glocklueng/open-bioreactor/CAD_hardwareDesign/Assembly Prototype.jpg

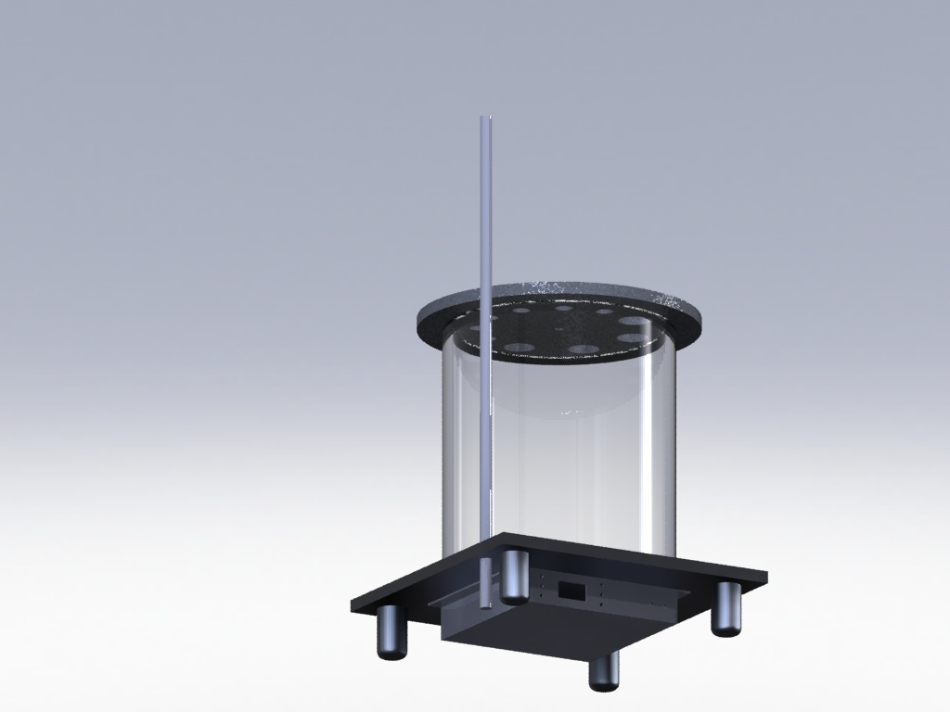
CAD_hardwareDesign/Assembly Prototype.jpg
