glocklueng/open-bioreactor/CAD_hardwareDesign/Assembly Prototype.SLDASM

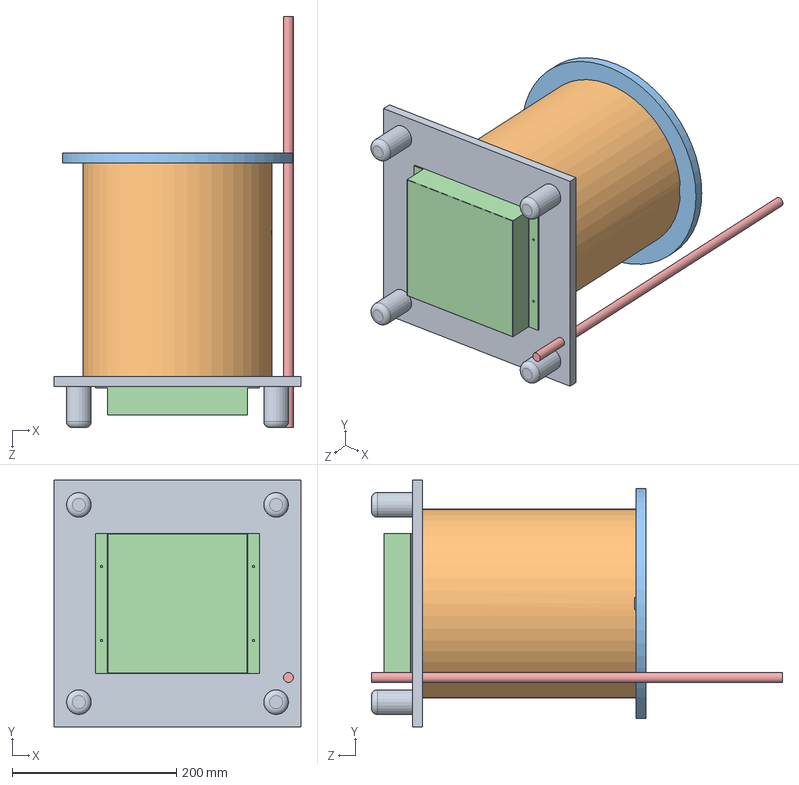
[picture p2: CAD file, 2011-11-10]
CAD_hardwareDesign/Assembly Prototype.SLDASM
300.0 x 300.0 x 500.0 mm
Bottom plate
Reservoir
Top
Bottom box
Motor support
