glocklueng/open-bioreactor/CAD_hardwareDesign/Bottom plate.SLDPRT

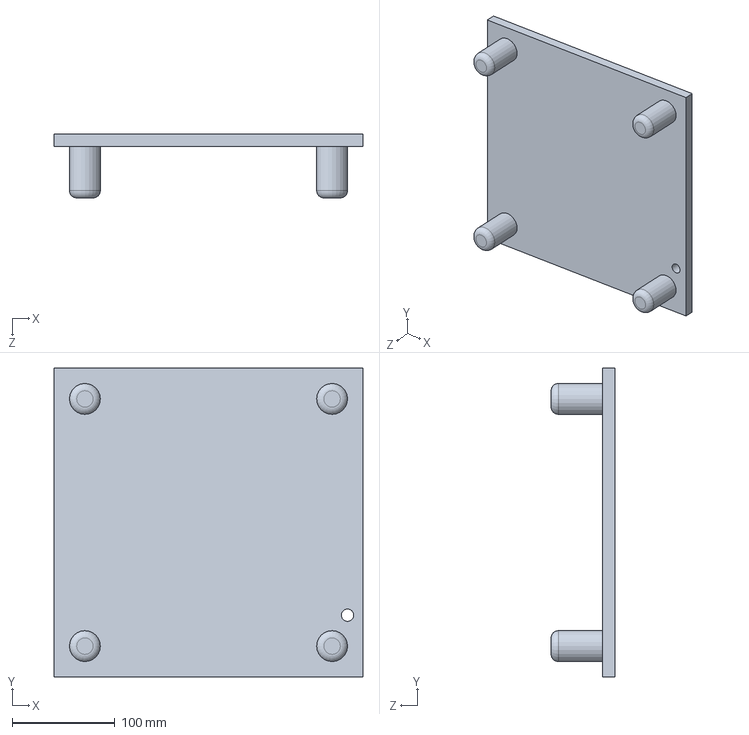
[picture p3: CAD file, 2011-11-10]
CAD_hardwareDesign/Bottom plate.SLDPRT
300.0 x 300.0 x 62.0 mm
