glocklueng/open-bioreactor/CAD_hardwareDesign/Reservoir.SLDPRT

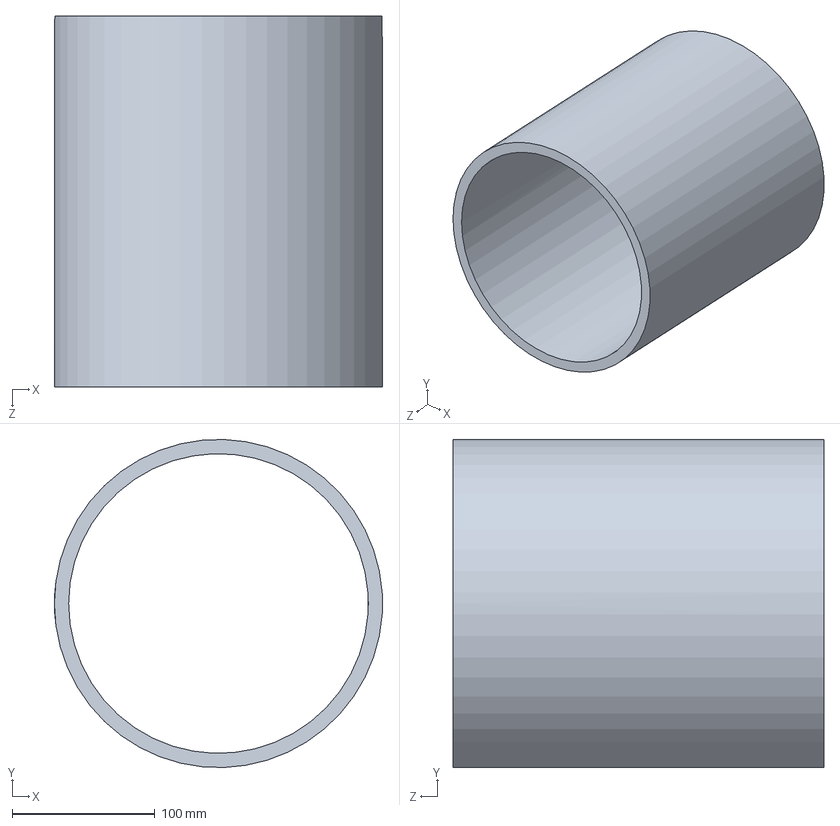
[picture p4: CAD file, 2011-11-10]
CAD_hardwareDesign/Reservoir.SLDPRT
230.0 x 229.9 x 260.0 mm
