glocklueng/open-bioreactor/CAD_hardwareDesign/Bottom box.SLDPRT

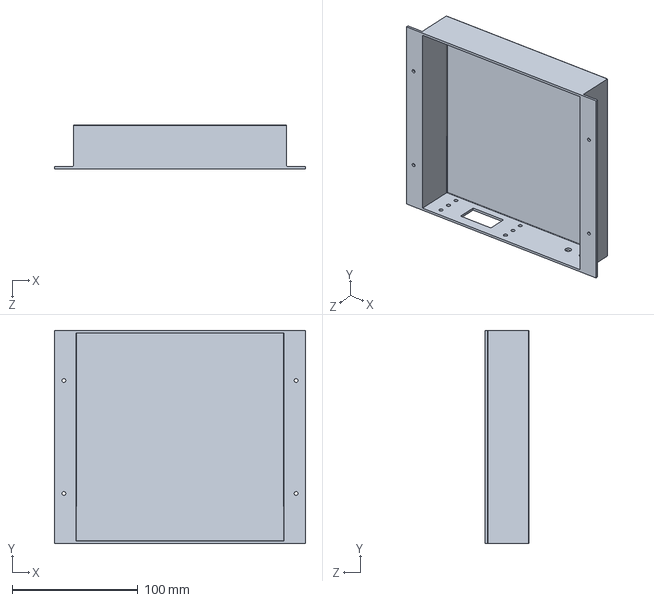
[picture p5: CAD file, 2011-11-10]
CAD_hardwareDesign/Bottom box.SLDPRT
200.0 x 170.0 x 35.0 mm
