glocklueng/open-bioreactor/CAD_hardwareDesign/Motor support.SLDPRT

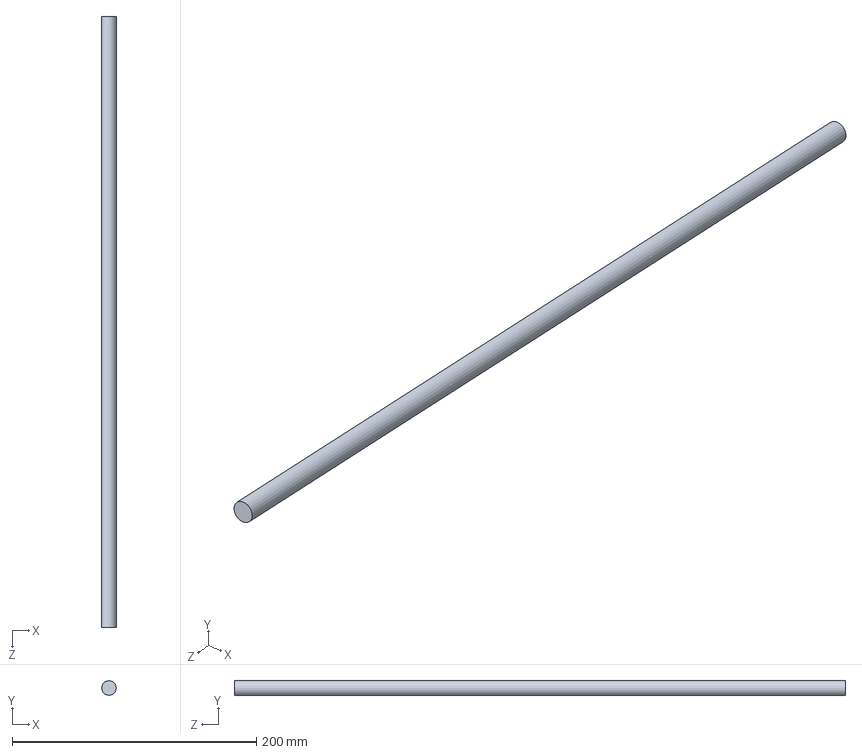
[picture p6: CAD file, 2011-11-10]
CAD_hardwareDesign/Motor support.SLDPRT
12.0 x 12.0 x 500.0 mm
