glocklueng/open-bioreactor/CAD_hardwareDesign/Top.SLDPRT

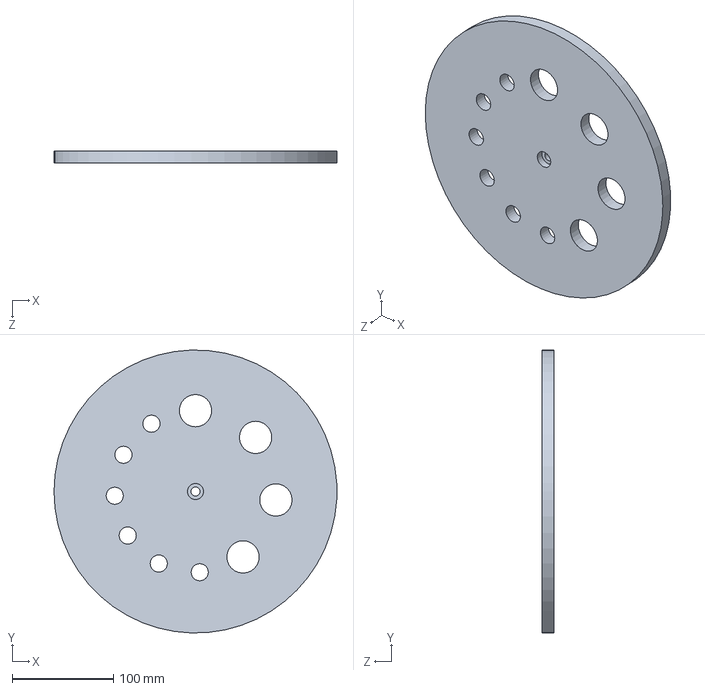
[picture p7: CAD file, 2011-11-10]
CAD_hardwareDesign/Top.SLDPRT
280.0 x 279.9 x 12.0 mm
