glocklueng/open-bioreactor/(list of files, cad)

Other CAD files:
CAD_hardwareDesign/Assembly Prototype.SLDDRW
CAD_hardwareDesign/Bottom box.SLDDRW
CAD_hardwareDesign/Bottom plate.SLDDRW
CAD_hardwareDesign/Reservoir.SLDDRW
CAD_hardwareDesign/Top.SLDDRW
