glocklueng/open-bioreactor/CAD_hardwareDesign/Bottom box.PDF

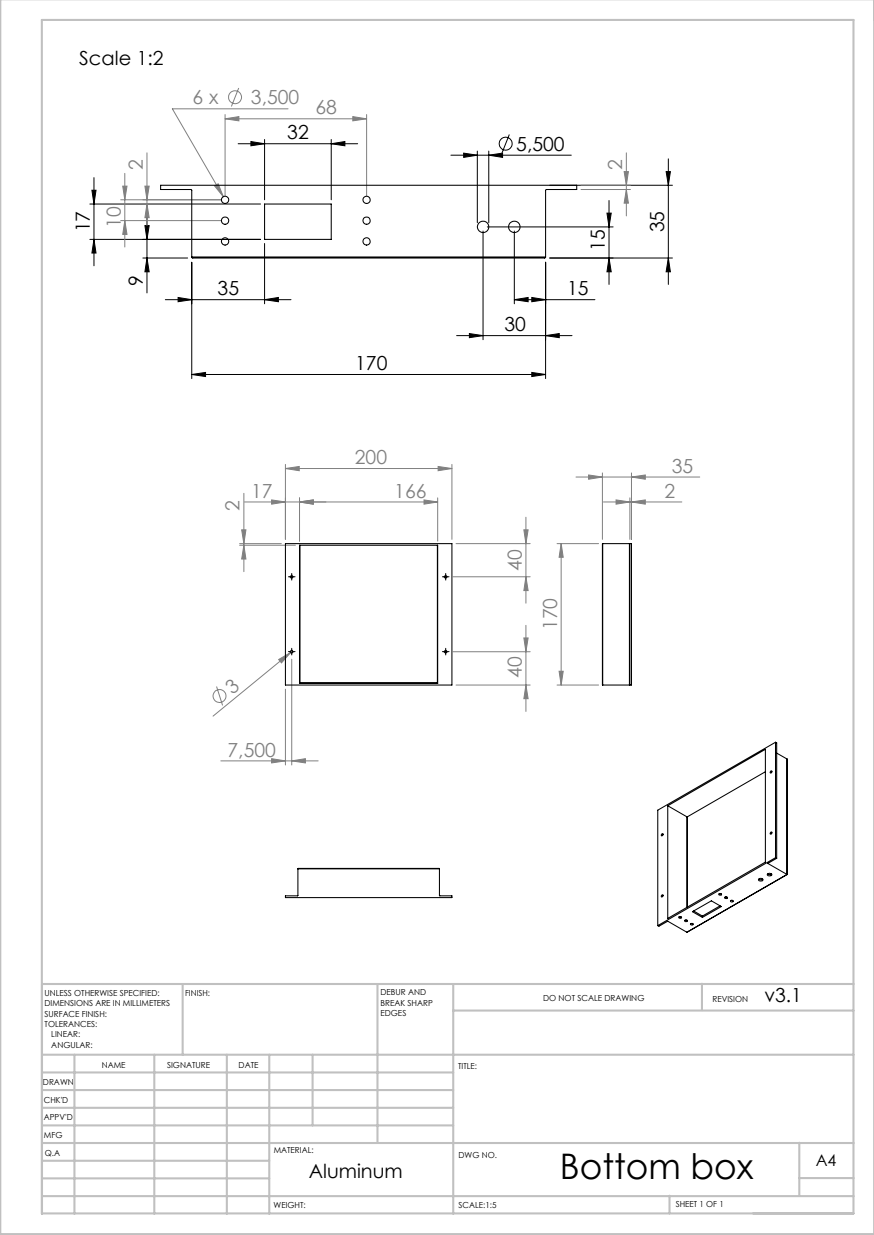
[picture p8: page 1]
Scale 1:2; SCALE:1:5; SHEET 1 OF 1; DO NOT SCALE DRAWING; REVISION; DEBUR AND BREAK SHARP; UNLESS OTHERWISE SPECIFIED:; FINISH:

DIMENSIONS ARE IN MILLIMETERS
SURFACE FINISH:
TOLERANCES:
LINEAR:
ANGULAR:

NAME | SIGNATURE | DATE | | | | TITLE:

DRAWN
CHK'D
APPV'D
MFG
Q.A | | | | MATERIAL: Aluminum | Bottom box WEIGHT: DWG NO. | A4
