glocklueng/open-bioreactor/CAD_hardwareDesign/Bottom plate.PDF

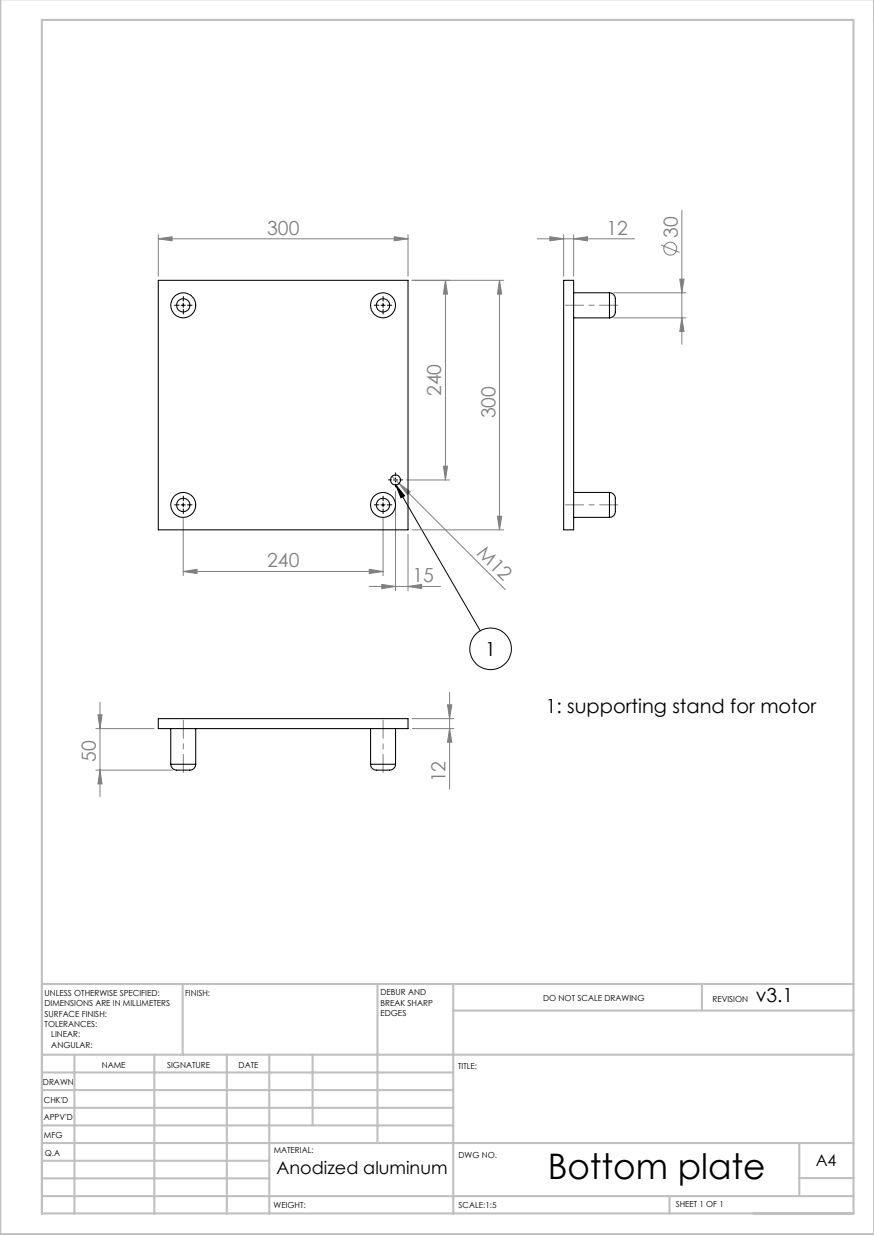
[picture p9: page 1]
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

1: supporting stand for motor

DIMENSIONS ARE IN MILLIMETERS
SURFACE FINISH:
TOLERANCES:
LINEAR:
ANGULAR:

NAME | SIGNATURE | DATE | | | | TITLE:

DRAWN
CHK'D
APPV'D
MFG
Q.A | | | | MATERIAL: Anodized aluminum | Bottom plate WEIGHT: DWG NO. | A4
