glocklueng/open-bioreactor/CAD_hardwareDesign/Assembly Prototype.PDF

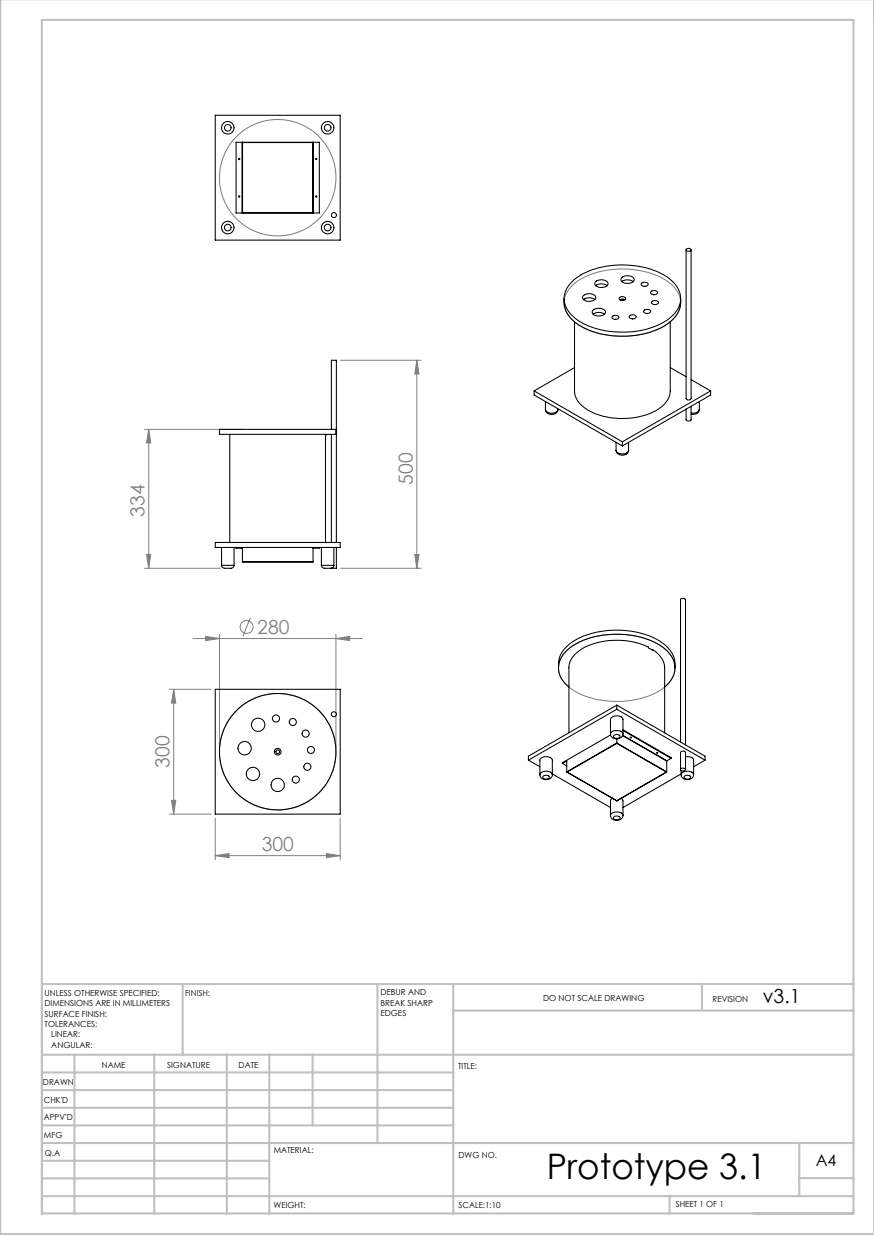
[picture p10: page 1]
SCALE:1:10; SHEET 1 OF 1; DO NOT SCALE DRAWING; REVISION; DEBUR AND BREAK SHARP; UNLESS OTHERWISE SPECIFIED:; FINISH:

DIMENSIONS ARE IN MILLIMETERS
SURFACE FINISH:
TOLERANCES:
LINEAR:
ANGULAR:

NAME | SIGNATURE | DATE | | | | TITLE:
Q.A | | | | MATERIAL: | Prototype 3.1 WEIGHT: DWG NO. | A4

DRAWN
CHK'D
APPV'D
MFG
