glocklueng/open-bioreactor/CAD_hardwareDesign/Reservoir.PDF

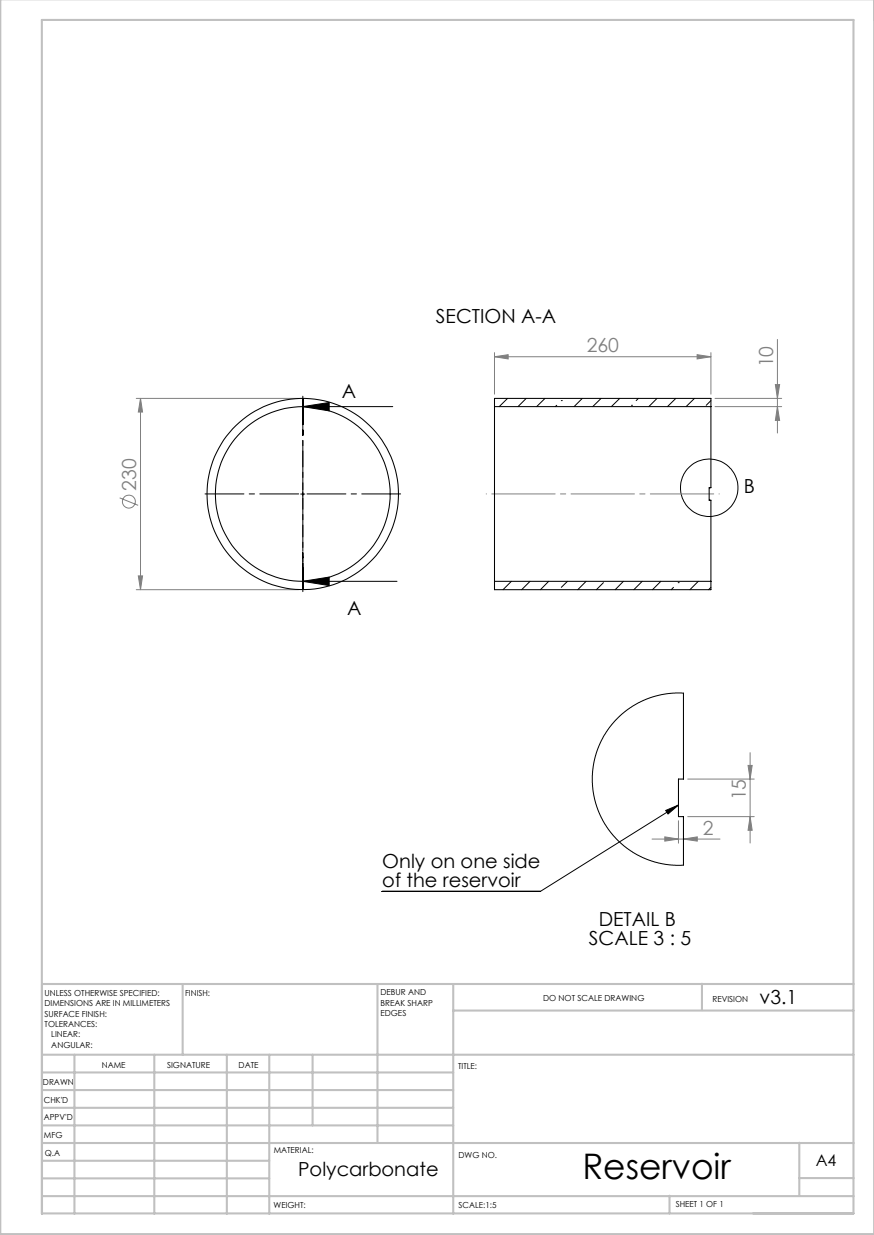
[picture p11: page 1]
SECTION A-A; DETAIL B SCALE 3 : 5; SCALE:1:5; SHEET 1 OF 1; DO NOT SCALE DRAWING; REVISION; DEBUR AND BREAK SHARP; UNLESS OTHERWISE SPECIFIED:; FINISH:

Only on one side
of the reservoir

DIMENSIONS ARE IN MILLIMETERS
SURFACE FINISH:
TOLERANCES:
LINEAR:
ANGULAR:

NAME | SIGNATURE | DATE | | | | TITLE:

DRAWN
CHK'D
APPV'D
MFG
Q.A | | | | MATERIAL: Polycarbonate | Reservoir WEIGHT: DWG NO. | A4
