glocklueng/open-bioreactor/CAD_hardwareDesign/Top.PDF

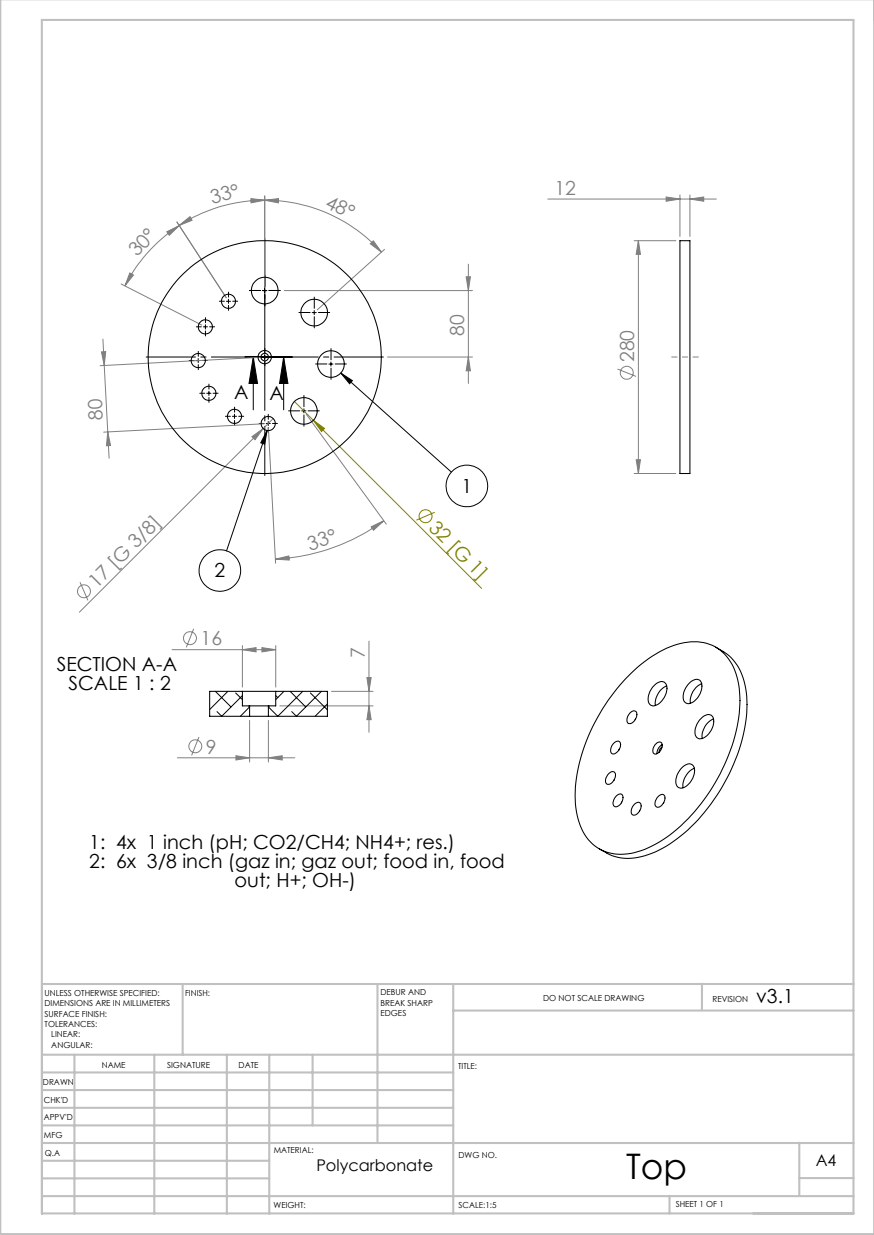
[picture p12: page 1]
SECTION A-A SCALE 1 : 2; out; H+; OH-); SCALE:1:5; SHEET 1 OF 1; DO NOT SCALE DRAWING; REVISION; DEBUR AND BREAK SHARP; UNLESS OTHERWISE SPECIFIED:; FINISH:

1: 4x 1 inch (pH; CO2/CH4; NH4+; res.)
2: 6x 3/8 inch (gaz in; gaz out; food in, food

DIMENSIONS ARE IN MILLIMETERS
SURFACE FINISH:
TOLERANCES:
LINEAR:
ANGULAR:

NAME | SIGNATURE | DATE | | | | TITLE:

DRAWN
CHK'D
APPV'D
MFG
Q.A | | | | MATERIAL: Polycarbonate | Top WEIGHT: DWG NO. | A4
