glocklueng/open-bioreactor/Eagle_PCB-files/pH-meter-v1-1_schematic.pdf

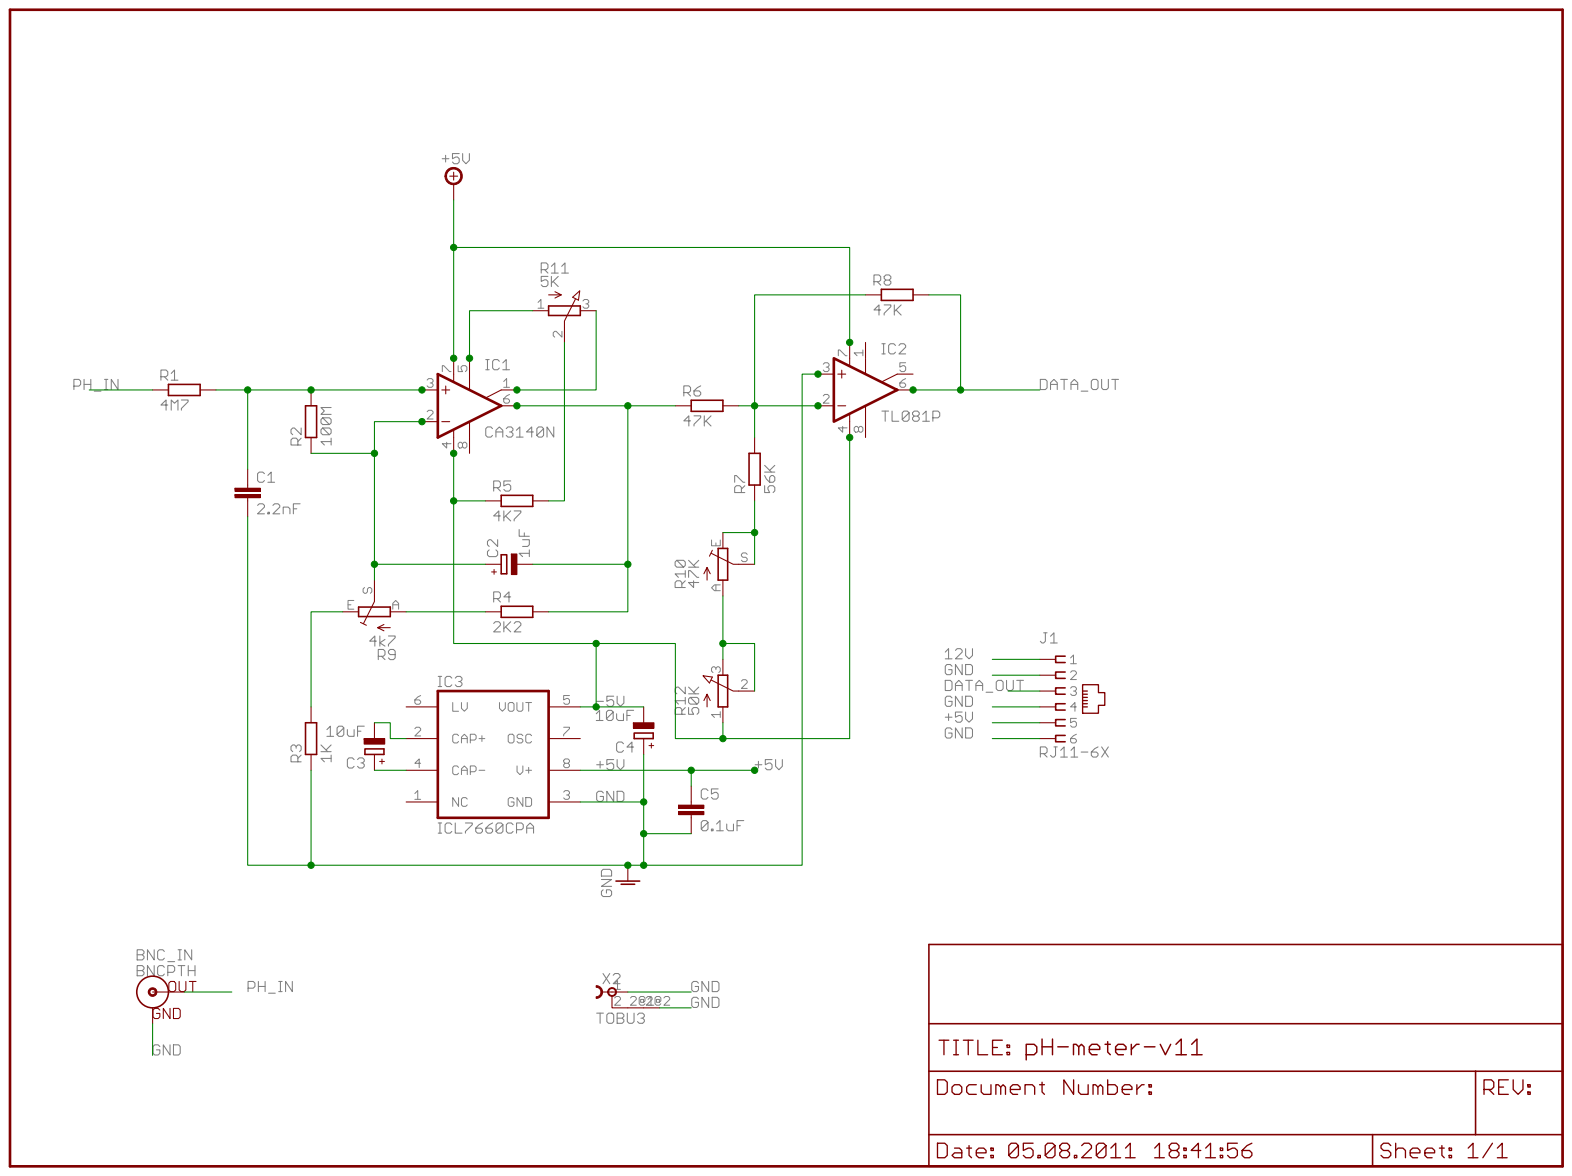
[picture p13: page 1]
