glocklueng/open-bioreactor/Eagle_PCB-files/pH-meter-v1-1_PCB.pdf

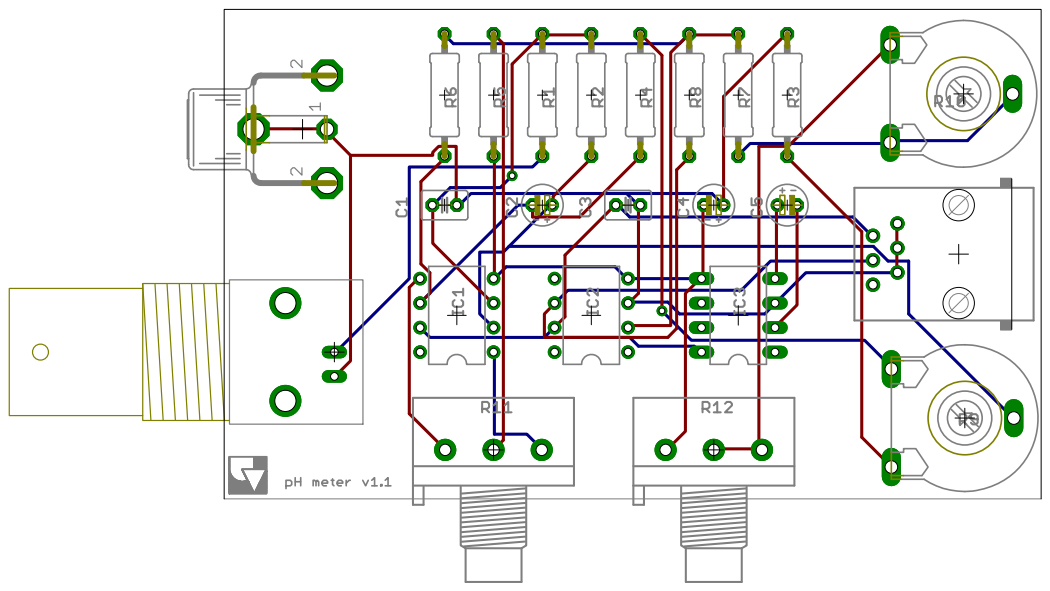
[picture p14: page 1]
