glocklueng/open-bioreactor/Arduino_source-code/Bioreactor/ethernet.ino

void ethernetSetup();
void ethernetSyncNTPTime();
unsigned long ethernetSendNTPpacket(byte *address);
void ethernetUpdateNTPTimeStamp();
unsigned long ethernetGetTimeStamp();
char * ethernetGetTimeStampChar();
void ethernetPushLog(char *logString);
void ethernetPushStatus();
void ethernetGetCommand();

/*
  Web client
 
 This sketch connects to a website (http://www.google.com)
 using an Arduino Wiznet Ethernet shield. 
 
 Circuit:
 * Ethernet shield attached to pins 10, 11, 12, 13
 
 created 18 Dec 2009
 by David A. Mellis
 
 
 Udp NTP Client
 
 Get the time from a Network Time Protocol (NTP) time server
 Demonstrates use of UDP sendPacket and ReceivePacket 
 For more on NTP time servers and the messages needed to communicate with them, 
 see http://en.wikipedia.org/wiki/Network_Time_Protocol
 
 created 4 Sep 2010 
 by Michael Margolis
 modified 17 Sep 2010
 by Tom Igoe
 
 This code is in the public domain.
 
 */


#define MAX_HTTP_STRING_LENGTH 2048    // in bytes; max. http return string to read  
// (reserve space for the http header !AND! the JSON command string)
#define MAX_COMMAND_STRING_LENGTH 400 // in bytes; max. JSON return string to read 



// Enter a MAC address and IP address for the Arduino controller below.
// The IP address is reserved on the routher for this Arduino controller.
byte mac[] = {
  0xDE, 0xAD, 0xBE, 0xEF, 0xFE, 0xED};
byte ip[] = {
  10,0,0,3}; // reserved IP adress of the Arduino



// Parameters for the NTP clock
unsigned int localPort = 8888;      // local port to listen for UDP packets
IPAddress server(10,0,0,2); // local NTP server 
const int NTP_PACKET_SIZE= 48; // NTP time stamp is in the first 48 bytes of the message
byte packetBuffer[NTP_PACKET_SIZE]; //buffer to hold incoming and outgoing packets 
unsigned long epoch = 0; // Unix time (starts on Jan 1 1970)
unsigned long epochTimeStampDiff = 0;

char timeStampCharBuffer[35]; // for the convertion of unsigned long into char of 'epoch'
char *pointerToTimeStampCharBuffer;


// A UDP instance to let us send and receive packets over UDP
EthernetUDP Udp;

// Initialize the Ethernet client library
// with the IP address and port of the server 
// that you want to connect to (port 80 is default for HTTP):
EthernetClient client;

void ethernetSetup()
{
  // the ethernet pin has been initialized in the main setup() from Bioreactor
  Ethernet.begin(mac,ip);
  Udp.begin(localPort);
  Serial.println("Ethernet successfully initialized.");
}


void ethernetSyncNTPTime()
{
  epochTimeStampDiff = millis();

  digitalWrite(PIN_SD_CARD,HIGH); // Disable SD card first (NEVER FORGET THIS!)
  unsigned long duration = millis();
  ethernetSendNTPpacket(server); // send an NTP packet to a time server

    if ( Udp.parsePacket() ) 
  { 	    
    // We've received a packet, read the data from it
    Udp.read(packetBuffer,NTP_PACKET_SIZE);  // read the packet into the buffer

    //the timestamp starts at byte 40 of the received packet and is four bytes,
    // or two words, long. First, esxtract the two words:

    unsigned long highWord = word(packetBuffer[40], packetBuffer[41]);
    unsigned long lowWord = word(packetBuffer[42], packetBuffer[43]);  
    // combine the four bytes (two words) into a long integer
    // this is NTP time (seconds since Jan 1 1900):
    unsigned long secsSince1900 = highWord << 16 | lowWord;  
    if(DEBUG)Serial.print("Seconds since Jan 1 1900 = " );
    if(DEBUG)Serial.println(secsSince1900);               

    // now convert NTP time into everyday time:
    if(DEBUG)Serial.print("Unix time = ");
    // Unix time starts on Jan 1 1970. In seconds, that's 2208988800:
    const unsigned long seventyYears = 2208988800UL;     
    // subtract seventy years:
    epoch = secsSince1900 - seventyYears;  
    // print Unix time:
    Serial.println(epoch);                               


    // print the hour, minute and second
    if(DEBUG)
    {
      Serial.print("The UTC time is ");       // UTC is the time at Greenwich Meridian (GMT)
      Serial.print((epoch  % 86400L) / 3600); // print the hour (86400 equals secs per day)
      Serial.print(':');  
      if ( ((epoch % 3600) / 60) < 10 ) 
      {
        // In the first 10 minutes of each hour, we'll want a leading '0'
        Serial.print('0');
      }
      Serial.print((epoch  % 3600) / 60); // print the minute (3600 equals secs per minute)
      Serial.print(':'); 
      if ( (epoch % 60) < 10 ) 
      {
        // In the first 10 seconds of each minute, we'll want a leading '0'
        Serial.print('0');
      }
      Serial.println(epoch %60); // print the second
    }


    if(DEBUG)
    {
      duration = millis() - duration; 
      Serial.print("To get the NTP time stamp took: [ms]");
      Serial.println(duration);
    }

  }

  if(DEBUG)Serial.println("Time stamp updated.");
}



// send an NTP request to the time server at the given address 
unsigned long ethernetSendNTPpacket(IPAddress& address)
{
  // set all bytes in the buffer to 0
  memset(packetBuffer, 0, NTP_PACKET_SIZE); 
  // Initialize values needed to form NTP request
  // (see URL above for details on the packets)
  packetBuffer[0] = 0b11100011;   // LI, Version, Mode
  packetBuffer[1] = 0;     // Stratum, or type of clock
  packetBuffer[2] = 6;     // Polling Interval
  packetBuffer[3] = 0xEC;  // Peer Clock Precision
  // 8 bytes of zero for Root Delay & Root Dispersion
  packetBuffer[12]  = 49; 
  packetBuffer[13]  = 0x4E;
  packetBuffer[14]  = 49;
  packetBuffer[15]  = 52;

  // all NTP fields have been given values, now
  // you can send a packet requesting a timestamp:
  if(DEBUG)Serial.print("Requesting NTP timestamp from server: "); 	   
  if(DEBUG)Serial.println(address); 	   
  Udp.beginPacket(address, 123); //NTP requests are to port 123
  Udp.write(packetBuffer,NTP_PACKET_SIZE);
  Udp.endPacket(); 


  if(DEBUG)Serial.println("NTP timestamp sent to server."); 	   
}

void ethernetUpdateNTPTimeStamp()
{
  //this function is done for the case the NTP server is unreachable

  //check if there is an overflow of the millis()  
  unsigned long now = millis();
  if(now < epochTimeStampDiff)
  {
    epochTimeStampDiff = millis();
    ethernetSyncNTPTime();
    return;
    // else: other solution: timer0_overflow_count = 0; // set timer0 that is used by millis to 0
  }

  epoch += (now-epochTimeStampDiff)/1000; // because epoch is in seconds and now in milliseconds
  epochTimeStampDiff = now; 
  if(DEBUG)
  {
    Serial.print("The UTC time is ");       // UTC is the time at Greenwich Meridian (GMT)
    Serial.print((epoch  % 86400L) / 3600); // print the hour (86400 equals secs per day)
    Serial.print(':');  

    if ( ((epoch % 3600) / 60) < 10 ) 
    {
      // In the first 10 minutes of each hour, we'll want a leading '0'
      Serial.print('0');
    }
    Serial.print((epoch  % 3600) / 60); // print the minute (3600 equals secs per minute)
    Serial.print(':'); 
    if ( (epoch % 60) < 10 ) 
    {
      // In the first 10 seconds of each minute, we'll want a leading '0'
      Serial.print('0');
    }
    Serial.println(epoch %60); // print the second

  } 

}



unsigned long ethernetGetTimeStamp()
{
  //first update the time stamp then return the new value
  ethernetUpdateNTPTimeStamp();
  return epoch; 
}

char * ethernetGetTimeStampChar()
{
  //first update the time stamp then return the new value
  ethernetUpdateNTPTimeStamp();


  pointerToTimeStampCharBuffer = ultoa(epoch, timeStampCharBuffer, 10);
  if(DEBUG)
  {
    Serial.print("The converted epoch time (to char) is: ");
    Serial.println(pointerToTimeStampCharBuffer);
  }
  return pointerToTimeStampCharBuffer;

}

void ethernetPushStatus()
{
  digitalWrite(PIN_SD_CARD,HIGH); // Disable SD card first
  //open a connection and try to print 
  if(DEBUG)Serial.println("PUSH STATUS: Connecting to server...");
  ethernetOpenConnection80();
  if (client.connected()) {

    char pushUrl[50];

    strcpy(pushUrl,"GET /bioReacTor/setStatus.php?");
    char mode[3];
    itoa(BIOREACTOR_MODE,mode,10);
    strcat(pushUrl,mode);
    strcat(pushUrl," HTTP/1.0\n\n");

    if (DEBUG) Serial.print("Push URL: ");
    if (DEBUG) Serial.println(pushUrl);
    client.println(pushUrl);
    if (DEBUG) Serial.println("The status has been pushed to the server.");
  }
  client.stop();
  if (DEBUG) Serial.println("PUSH STATUS: Disconnected.");
}

void ethernetOpenConnection80() {
  client.connect(server,80);
  long start=millis(); 
  while (! client.connected() && ((millis()-start)<500))
  {
    delay(1);
  }
  if (DEBUG) Serial.print("Connection achieved in (ms): ");
  if (DEBUG) Serial.println(millis()-start);
}

void ethernetPushLog(char *logString)
{
  digitalWrite(PIN_SD_CARD,HIGH); // Disable SD card first
  //open a connection and try to print 
  if(DEBUG)Serial.println("PUSH LOG: Connecting to server...");
  ethernetOpenConnection80();
  if (client.connected()) {

    char pushUrl[LOG_MAX_LENGTH+50];

    strcpy(pushUrl,"GET /bioReacTor/add.php?");
    strcat(pushUrl,logString);
    strcat(pushUrl," HTTP/1.0\n\n");

    if (DEBUG) Serial.print("Push URL: ");
    if (DEBUG) Serial.println(pushUrl);
    client.println(pushUrl);
    if (DEBUG) Serial.println("The log has been pushed to the server.");
  }
  client.stop();
  if (DEBUG) Serial.println("PUSH LOG: Disconnected.");
}

void ethernetGetCommand()
{
  digitalWrite(PIN_SD_CARD,HIGH); // Disable SD card first
  String jsonCommand = String(""); // reinitialize alocated string
  //char jsonCommandBuffer[MAX_HTTP_STRING_LENGTH]; // reserve space
  //  if(DEBUG)Serial.print("String initialized has length of: ");
  //  if(DEBUG)Serial.println(sizeof(jsonCommand));
  //open a connection and try to read the JSON command 
  if(DEBUG)Serial.println("Connecting to get newcommand...");

  ethernetOpenConnection80();

  // read the JSON object from the server and save it in a local String
  // for more informations look up www.json.org
  int jsonController = 0;
  client.println("GET /bioReacTor/command HTTP/1.0\n"); //connect to the command page of the server

  int STATUS=0; // the JSON didn't start yet
  /* STATUS:
   1 : the JSON started
   2 : we get the field name
   3 : we get the value
   */

  long start=millis();
  char fieldName[20];
  char fieldValue[10];
  while (client.connected() && ((millis()-start)<1000)) 
  {
    if (client.available()) {

      char readChar = client.read();
      //    if(DEBUG) Serial.print(readChar);

      switch(STATUS)
      {
      case 0:
        if(readChar == '{') {
          STATUS=1;
          fieldName[0]='\0';
          fieldValue[0]='\0';
        }
        break;
      case 1: // we are receiving the fieldName
        if(readChar == ':') {
          STATUS=2;
        } 
        else {
          int len=strlen(fieldName);
          fieldName[len] = readChar;
          fieldName[len + 1] = '\0';
        }
        break;

      case 2:
        if(readChar == ',') {
          ethernetParseCommandValue(fieldName, atof(fieldValue));
          fieldName[0]='\0';
          fieldValue[0]='\0';
          STATUS=1;
        } 
        else if (readChar == '}') {
          ethernetParseCommandValue(fieldName, atof(fieldValue));
          fieldName[0]='\0';
          fieldValue[0]='\0';
          STATUS=3;
        } 
        else {
          int len=strlen(fieldValue);
          fieldValue[len] = readChar;
          fieldValue[len + 1] = '\0';
        }
        break;
      case 3:
        break; 
        break;
      default:
        Serial.println("ERROR in fetching command");
      }
    }
  } // end while
  client.stop();
  if (DEBUG) Serial.print("Received command file in (ms): ");
  if (DEBUG) Serial.println(millis()-start);


}


void ethernetParseCommandValue(char *fieldName, double extractedValueFloat)
{
  int extractedValueInt=(int)extractedValueFloat;
  if (strcmp(fieldName,"liquidTemp")==0) {
    // first check if there is a difference between the read value and the stored one
    // (because floats are used, an error value of 0.05 has been set!)
    if(HEATING_TEMPERATURE_LIMIT >= extractedValueFloat + 0.05 || HEATING_TEMPERATURE_LIMIT <= extractedValueFloat-0.05)
    {
      // check if the input value is valid, then save it
      if(extractedValueFloat > HEATING_MAX_ALLOWED_LIMIT)
      {
        if(DEBUG)Serial.println("WARNING: The input temperature is to high! New temperature value has not been set.");
      }
      else if (extractedValueFloat < HEATING_MIN_ALLOWED_LIMIT)
      {
        if(DEBUG)Serial.println("WARNING: The input temperature is to low! New temperature value has not been set.");
      }
      else
      {
        HEATING_TEMPERATURE_LIMIT = extractedValueFloat;
        if(DEBUG)Serial.print("The new temperature has been successfully set to: [C]");
        if(DEBUG)Serial.println(HEATING_TEMPERATURE_LIMIT);
      }
    }
    else if(DEBUG)Serial.println("The set temperature is the same as the saved one (deviation <0.05).");
  } 
  else if (strcmp(fieldName,"liquidLevelMax")==0) {
    if(extractedValueInt != LIQUID_LEVEL_WEB_MAX)
    {
      // check if the input value is valid, then save it
      if(extractedValueInt > LIQUID_LEVEL_PHYSICAL_MAX_INTERVAL)
      {
        if(DEBUG)Serial.println("WARNING: The input liquid level is to high! New liquid value has not been set.");
      }
      else if (extractedValueInt < LIQUID_LEVEL_PHYSICAL_MIN_INTERVAL)
      {
        if(DEBUG)Serial.println("WARNING: The input liquid level negative! New liquid value has not been set.");
      }
      else
      {
        LIQUID_LEVEL_WEB_MAX = extractedValueInt;
        if(DEBUG)Serial.print("The new liquid level has been successfully set to [Arduino AD interval]: ");
        if(DEBUG)Serial.println(LIQUID_LEVEL_WEB_MAX);
      }
    }
    else if(DEBUG)Serial.println("The set liquid level is the same as the saved one.");
  } 
  else if (strcmp(fieldName,"liquidLevelMin")==0) {
    if(extractedValueInt != LIQUID_LEVEL_WEB_MAX)
    {
      // check if the input value is valid, then save it
      if(extractedValueInt > LIQUID_LEVEL_PHYSICAL_MAX_INTERVAL)
      {
        if(DEBUG)Serial.println("WARNING: The input liquid level is to high! New liquid value has not been set.");
      }
      else if (extractedValueInt < LIQUID_LEVEL_PHYSICAL_MIN_INTERVAL)
      {
        if(DEBUG)Serial.println("WARNING: The input liquid level negative! New liquid value has not been set.");
      }
      else
      {
        LIQUID_LEVEL_WEB_MIN = extractedValueInt;
        if(DEBUG)Serial.print("The new liquid level has been successfully set to [Arduino AD interval]: ");
        if(DEBUG)Serial.println(LIQUID_LEVEL_WEB_MIN);
      }
    }
    else if(DEBUG)Serial.println("The set liquid level is the same as the saved one.");
  } 
  else if (strcmp(fieldName,"pH")==0) {
    // first check if there is a difference between the read value and the stored one
    // (because floats are used, an error value of 0.05 has been set!)
    if(pH_SET >= extractedValueFloat+0.05 || pH_SET <= extractedValueFloat-0.05)
    {
      // check if the input value is valid, then save it
      if(extractedValueFloat > 14.0) // max pH level is 14
      {
        if(DEBUG)Serial.println("WARNING: The input pH level is to high! New pH value has not been set.");
      }
      else if (extractedValueFloat < 0.0) // min pH level is 0
      {
        if(DEBUG)Serial.println("WARNING: The input pH level negative! New pH value has not been set.");
      }
      else
      {
        pH_SET = extractedValueFloat;
        if(DEBUG)Serial.print("The new pH level has been successfully set to: ");
        if(DEBUG)Serial.println(pH_SET);
      }
    }
    else if(DEBUG)Serial.println("The set temperature is the same as the saved one (deviation <0.05).");

  } 
  else if (strcmp(fieldName,"waitTime")==0) {
    // Value read from WebUI is in min; the timer uses millisec!
    if(extractedValueInt != WAIT_TIME_BEFORE_PUMPING_OUT)
    {
      // check if the input value is valid, then save it
      if(extractedValueInt * MIN_TO_SEC > WAIT_TIME_BEFORE_PUMPING_OUT_MAX) // min und max values in [sec]!
      {
        if(DEBUG)Serial.print("WARNING: The Wait Time is to high! Maximum allowed Wait Time is [sec]:");
        if(DEBUG)Serial.println(WAIT_TIME_BEFORE_PUMPING_OUT_MAX);
      }
      else if (extractedValueInt * MIN_TO_SEC < WAIT_TIME_BEFORE_PUMPING_OUT_MIN)
      {
        if(DEBUG)Serial.print("WARNING: The Wait Time is to low! Minimum allowed Wait Time is [sec]:");
        if(DEBUG)Serial.println(WAIT_TIME_BEFORE_PUMPING_OUT_MIN);
      }
      else
      {
        WAIT_TIME_BEFORE_PUMPING_OUT = extractedValueInt; //in [min]
        PUMPING_OUT_TIMER = WAIT_TIME_BEFORE_PUMPING_OUT * MIN_TO_SEC * SEC_TO_MILLISEC; // in [millisec]
        timerPumpingOut.setInterval(PUMPING_OUT_TIMER); 
        if(DEBUG)Serial.print("The new Wait Time has been successfully set to [millisec]: ");
        if(DEBUG)Serial.println(PUMPING_OUT_TIMER);
      }
    }
    else if(DEBUG)Serial.println("The Wait Time is the same as the saved one.");
  } 
  else if (strcmp(fieldName,"methaneIn")==0) 
  {
    // values for auto-switching mode can be changed in any mode but the error-mode
    if(BIOREACTOR_MODE != BIOREACTOR_ERROR_MODE)
    {
      // first check if there is a difference between the read value and the stored one
      if(extractedValueInt != gasValvesGetAutoSwitchInterval(CH4)) 
      {
          gasValvesSetAutoSwitchInterval(CH4, extractedValueInt);
          gasValvesAutoSwitchMode(CH4);
          if(DEBUG)Serial.println("CH4 value's auto-switching parameter has been changed.");
        // check if the input value is valid, then save it
        if(extractedValueInt > 100 && extractedValueInt < 0 )// min. value is 0% max. value is 100%
        {
          Serial.print("WARNING: CH4 value's auto-switching parameter is invalid!. ");
          Serial.println("It has been corrected to fit the min. [0] and max. [100] allowed values.");
        }
      }
      else if(DEBUG)Serial.println("CH4 value's auto-switching parameter is the same as the saved one.");
    }
    else if(DEBUG) Serial.println("WARNING: In ERROR-MODE: CH4 value has not been switched to auto-switching mode");

    
    
  } 
  else if (strcmp(fieldName,"carbonDioxideIn")==0) 
  {
    // values for auto-switching mode can be changed in any mode but the error-mode
    if(BIOREACTOR_MODE != BIOREACTOR_ERROR_MODE)
    {
      // first check if there is a difference between the read value and the stored one
      if(extractedValueInt != gasValvesGetAutoSwitchInterval(CO2)) 
      {
          gasValvesSetAutoSwitchInterval(CO2, extractedValueInt);
          gasValvesAutoSwitchMode(CO2);
          if(DEBUG)Serial.println("CO2 value's auto-switching parameter has been changed.");
        // check if the input value is valid, then save it
        if(extractedValueInt > 100 && extractedValueInt < 0 )// min. value is 0% max. value is 100%
        {
          Serial.print("WARNING: CO2 value's auto-switching parameter is invalid!. ");
          Serial.println("It has been corrected to fit the min. [0] and max. [100] allowed values.");
        }
      }
      else if(DEBUG)Serial.println("CO2 value's auto-switching parameter is the same as the saved one.");
    }
    else if(DEBUG) Serial.println("WARNING: In ERROR-MODE: CO2 value has not been switched to auto-switching mode");

  } 
  else if (strcmp(fieldName,"nitrogenIn")==0) 
  {    
    // values for auto-switching mode can be changed in any mode but the error-mode
    if(BIOREACTOR_MODE != BIOREACTOR_ERROR_MODE)
    {
      // first check if there is a difference between the read value and the stored one
      if(extractedValueInt != gasValvesGetAutoSwitchInterval(N2)) 
      {
          gasValvesSetAutoSwitchInterval(N2, extractedValueInt);
          gasValvesAutoSwitchMode(N2);
          if(DEBUG)Serial.println("N2 value's auto-switching parameter has been changed.");
        // check if the input value is valid, then save it
        if(extractedValueInt > 100 && extractedValueInt < 0 )// min. value is 0% max. value is 100%
        {
          Serial.print("WARNING: N2 value's auto-switching parameter is invalid!. ");
          Serial.println("It has been corrected to fit the min. [0] and max. [100] allowed values.");
        }
      }
      else if(DEBUG)Serial.println("N2 value's auto-switching parameter is the same as the saved one.");
    }
    else if(DEBUG) Serial.println("WARNING: In ERROR-MODE: N2 value has not been switched to auto-switching mode");


    
  } 
  else if (strcmp(fieldName,"liquidIn")==0) 
  {

  } 
  else if (strcmp(fieldName,"liquidOut")==0) 
  {

  } 
  else if (strcmp(fieldName,"mode")==0) {
    // first check if there is a difference between the read value and the stored one
    // then check if in pumping mode; ONLY change from pumping mode if MANUAL mode is selected
    if(extractedValueInt != BIOREACTOR_MODE
      && (BIOREACTOR_MODE != BIOREACTOR_PUMPING_MODE 
      || (BIOREACTOR_MODE == BIOREACTOR_PUMPING_MODE && extractedValueInt == BIOREACTOR_MANUAL_MODE)))
    {
      // check if the input value is valid, then save it
      if(extractedValueInt == BIOREACTOR_STANDBY_MODE
        || extractedValueInt == BIOREACTOR_RUNNING_MODE
        || extractedValueInt == BIOREACTOR_MANUAL_MODE)
      {

        //switch Bioreactor mode
        BIOREACTOR_MODE = extractedValueInt;
        if(DEBUG)Serial.print("The Bioreactor has been set to a new state: ");
        if(DEBUG)Serial.println(BIOREACTOR_MODE);
      }
      else
      {
        if(DEBUG)Serial.print("WARNING: The Bioreactor state is invalid!. The state is: ");
        if(DEBUG)Serial.println(extractedValueInt);
      }
    }
    else if(DEBUG)Serial.println("The Bioreactor state is the same as the saved one.");

  } 
  else if (strcmp(fieldName,"pumpOut")==0) {
    //---------Set pumpOut state ----------
    // only get the pump's state if in MANUAL mode
    if(BIOREACTOR_MODE == BIOREACTOR_MANUAL_MODE)
    {


      // first check if there is a difference between the read value and the stored one
      if(extractedValueInt != relaySwitchPumpOutGetState())
      {
        // check if the input value is valid, then save it
        if(extractedValueInt == 1 || extractedValueInt == 0 )
        {
          //turn ON or OFF
          if(extractedValueInt == 1) relaySwitchPumpOutTurnOn();
          else relaySwitchPumpOutTurnOff(); // if extractedValueInt = 0
          if(DEBUG)Serial.println("PumpOut has been set to a new state.");
        }
        else
        {
          if(DEBUG)Serial.println("WARNING: PumpOut state is invalid!.");
        }
      }
      else if(DEBUG)Serial.println("PumpOut state is the same as the saved one.");
    }
    else if(DEBUG) Serial.println("Not in MANUAL mode: PumpOut's value not taken");
  } 
  else if (strcmp(fieldName,"pumpIn")==0) {

    //---------Set pumpIn state ----------
    // only get the pump's state if in MANUAL mode
    if(BIOREACTOR_MODE == BIOREACTOR_MANUAL_MODE)
    {
      // first check if there is a difference between the read value and the stored one
      if(extractedValueInt != relaySwitchPumpInGetState())
      {
        // check if the input value is valid, then save it
        if(extractedValueInt == 1 || extractedValueInt == 0 )
        {
          //turn ON or OFF
          if(extractedValueInt == 1) relaySwitchPumpInTurnOn();
          else relaySwitchPumpInTurnOff(); // if extractedValueInt = 0
          if(DEBUG)Serial.println("PumpIn has been set to a new state.");
        }
        else
        {
          if(DEBUG)Serial.println("WARNING: PumpIn state is invalid!.");
        }
      }
      else if(DEBUG)Serial.println("PumpIn state is the same as the saved one.");
    }
    else if(DEBUG) Serial.println("Not in MANUAL mode: PumpIn's value not taken");
  } 
  else if (strcmp(fieldName,"motor")==0) {

    //---------Set motor state ----------
    // only get the motor's state if in MANUAL mode
    if(BIOREACTOR_MODE == BIOREACTOR_MANUAL_MODE)
    {


      // first check if there is a difference between the read value and the stored one
      if(extractedValueInt != relaySwitchMotorGetState())
      {
        // check if the input value is valid, then save it
        if(extractedValueInt == 1 || extractedValueInt == 0 )
        {
          //turn ON or OFF
          if(extractedValueInt == 1) relaySwitchMotorTurnOn();
          else relaySwitchMotorTurnOff(); // if extractedValueInt = 0
          if(DEBUG)Serial.println("The motor has been set to a new state.");
        }
        else
        {
          if(DEBUG)Serial.println("WARNING: The motor state is invalid!.");
        }
      }
      else if(DEBUG)Serial.println("The motor state is the same as the saved one.");


    }
    else if(DEBUG) Serial.println("Not in MANUAL mode: Motor's value not taken");
  } 
//  else if (strcmp(fieldName,"methane")==0) {
//   //---------Set gas valve (methane) state ----------
//    // only get the pump's state if in MANUAL mode
//    if(BIOREACTOR_MODE == BIOREACTOR_MANUAL_MODE)
//    {
//
//      // first check if there is a difference between the read value and the stored one
//      if(extractedValueInt != gasValvesGetState(CH4))
//      {
//        // check if the input value is valid, then save it
//        if(extractedValueInt == 1 || extractedValueInt == 0 )
//        {
//          //turn ON or OFF
//          if(extractedValueInt == 1) gasValvesTurnOn(CH4);
//          else gasValvesTurnOff(CH4); // if extractedValueInt = 0
//          if(DEBUG)Serial.println("The gas valve (methane) has been set to a new state.");
//        }
//        else
//        {
//          if(DEBUG)Serial.println("WARNING: The gas valve (methane) state is invalid!.");
//        }
//      }
//       else if(DEBUG)Serial.println("The gas valve (methane) state is the same as the saved one.");
//    }
//    else if(DEBUG) Serial.println("Not in MANUAL mode: Gas valve's value not taken");
//    
//  }   
//  else if (strcmp(fieldName,"carbonDioxide")==0) {
//    //---------Set gas valve (carbonDioxide) state ----------
//    // only get the pump's state if in MANUAL mode
//    if(BIOREACTOR_MODE == BIOREACTOR_MANUAL_MODE)
//    {
//      // first check if there is a difference between the read value and the stored one
//      if(extractedValueInt != gasValvesGetState(CO2))
//      {
//        // check if the input value is valid, then save it
//        if(extractedValueInt == 1 || extractedValueInt == 0 )
//        {
//          //turn ON or OFF
//          if(extractedValueInt == 1) gasValvesTurnOn(CO2);
//          else gasValvesTurnOff(CO2); // if extractedValueInt = 0
//          if(DEBUG)Serial.println("The gas valve (carbonDioxide) has been set to a new state.");
//        }
//        else
//        {
//          if(DEBUG)Serial.println("WARNING: The gas valve (carbonDioxide) state is invalid!.");
//        }
//      }
//     
//
//
//    }
//    else if(DEBUG) Serial.println("Not in MANUAL mode: Gas valve's value not taken");
//
//  } 
//  else if (strcmp(fieldName,"nitrogen")==0) {
//
//    //---------Set gas valve (nitrogen) state ----------
//    // only get the pump's state if in MANUAL mode
//    if(BIOREACTOR_MODE == BIOREACTOR_MANUAL_MODE)
//    {
//
//      // first check if there is a difference between the read value and the stored one
//      if(extractedValueInt != gasValvesGetState(N2))
//      {
//        // check if the input value is valid, then save it
//        if(extractedValueInt == 1 || extractedValueInt == 0 )
//        {
//          //turn ON or OFF
//          if(extractedValueInt == 1) gasValvesTurnOn(N2);
//          else gasValvesTurnOff(N2); // if extractedValueInt = 0
//          if(DEBUG)Serial.println("The gas valve (nitrogen) has been set to a new state.");
//        }
//        else
//        {
//          if(DEBUG)Serial.println("WARNING: The gas valve (nitrogen) state is invalid!.");
//        }
//      }
//      else if(DEBUG)Serial.println("The gas valve (nitrogen) state is the same as the saved one.");
//
//
//    }
//
//    else if(DEBUG) Serial.println("Not in MANUAL mode: Gas valve's value not taken");
//
//
//  } 
}
