glocklueng/open-bioreactor/(commit log)

2011-09-14 initial import
    [PID.xls, REG_Kp7000_Td300_Ti15_Temp33Full.csv, data.csv]
2011-09-21 Move to Arduino RC 1 from beta (concearning libraries). Minor changes in liquid level update funciton.
2011-09-28 Code compatible with new libraries of Arduino IDE 1.0 RC. Minor security algorithms.
2011-10-11 Put the comma on one line, there is still a bug in String concatenation otherwise
    [logging.ino]
2011-10-13 Reactivate temperatureUpdate
2011-10-13 Add debug function to display all the temperatures
2011-10-14 Circumvent the sprintf float problem
    [logging.ino]
2011-10-14 Remove temperature formatting
2011-10-14 Fix bug in the opening of the ethernet connection
    [ethernet.ino]
2011-10-14 Use Dallas Library to look automaticaly for the ID of the device on the OneWire Bus
2011-10-14 Fix bug with formatting of 0.06
    [logging.ino]
2011-10-14 WebUI access changes: LiquidLevel min/max and Wait time can be set; Security function added for heating.
2011-10-18 Solved the Bug in SetPumpingOutTimer. All GasValves functions have been rewritten.
    [Bioreactor.ino, ethernet.ino, gasValves.ino]
2011-10-18 Small Methane error bug fixed
    [ethernet.ino]
2011-10-18 Gas Valve's name have been corrected.
    [gasValves.ino]
2011-11-02 Remove old Arduino files.
2011-11-10 Adding first version of the hardware design CAD files (SolidWorks).
2011-11-10 CAD design: slight material anotation changes (from french to english).
    [Bottom box.SLDDRW, Bottom plate.SLDDRW]
2011-11-14 Implementing auto-switching mode for gas-valves. First testing verstion.
2011-11-16 First implementation for auto-switching for gas valves. Only one operational. Fixing of bugs with gas valve's parameter logging.
    [Bioreactor.ino, ethernet.ino, gasValves.ino]
2011-11-16 Gas valves: patching bugs
    [gasValves.ino]
2011-11-17 Gas valves: patching bugs, manual ON-OFF switching disabled. Distingushing between extreme cases in % of on/off in gas valve webUI values.
    [gasValves.ino]
2011-12-01 Implementation of auto-switching algorithm for pumps.
2011-12-05 Solved inconsistencies in function declarations.
    [relaySwitch.ino]
2011-12-11 Correction of Laurent's version for liquid level floater.
    [Bioreactor.ino, ethernet.ino, global.ino, liquidLevel.ino]
2011-12-16 Adding Eagle files for the pH-meter (PCB layout and schematics).
